JB-toriel/Audio_Amp_BE_Elec/Montage1.asc

C1: cap; 10µ
C2: cap; 10µ
C3: cap; 1µ
C4: cap; 10n
C5: cap; 1n
C6: cap; 10n
C9: cap; 100n
C10: cap; 1n
R1: res; 2.2K
R2: res; 2.2K
R3: res; 100k
R4: res; 100k
R5: res; 1K
R6: res; 3.9k
R7: res; 8.2k
R8: res; 100k
R9: res; 1k
R10: res; 100
R11: res; 100k
R12: res; 47k
R13: res; 8.2k
R14: res; 39k
R15: res; 1k
R16: res; 100
R17: res; 100K
R19: res; 3.9k
R20: res; 39k
R21: res; 100
R22: res; 1k
U1: UniversalOpamp2
U2: UniversalOpamp2
U3: UniversalOpamp2
U4: UniversalOpamp2
U5: UniversalOpamp2
V1: voltage; SINE(1 1 15K)
V2: voltage; SINE(1 1 15K)
V3: voltage; 5
V4: voltage; 2.5; AC 1
V5: voltage; 2.5; AC 1
V6: voltage; 2.5; AC 1
Named nets: 0, VCC, VS1, VD, VG, VCC/2, VSG, VSA, VS, VSM
;tran 0 1ms 0 0.001ms
.ac dec 10 10 30K
