JB-toriel/Audio_Amp_BE_Elec/Circuit1_filtres/Circuit1.kicad_pcb

## KiCad design Circuit1_filtres/Circuit1.kicad_pcb (2020-01-26)

Schematic: Circuit1.sch

Parts:
C1, C2: 10u; C_1206_3216Metric_Pad1.42x1.75mm_HandSolder
C3: 1u; C_1206_3216Metric_Pad1.42x1.75mm_HandSolder
C4, C6: 10n; C_1206_3216Metric_Pad1.42x1.75mm_HandSolder
C5, C8: 1n; C_1206_3216Metric_Pad1.42x1.75mm_HandSolder
C7: 100n; C_1206_3216Metric_Pad1.42x1.75mm_HandSolder
J1: AudioJack3_Ground; Jack_3.5mm_PJ320D_Horizontal
J2: Conn_01x02_Female; PinHeader_1x02_P2.54mm_Vertical
J3: Conn_01x03_Female; PinHeader_1x03_P2.54mm_Vertical
R1, R2: 100k; R_1206_3216Metric_Pad1.42x1.75mm_HandSolder
R3, R6: 1k; R_1206_3216Metric_Pad1.42x1.75mm_HandSolder
R4, R9: 8.2k; R_1206_3216Metric_Pad1.42x1.75mm_HandSolder
R5: 3.9; R_1206_3216Metric_Pad1.42x1.75mm_HandSolder
R8: 3.9k; R_1206_3216Metric_Pad1.42x1.75mm_HandSolder
R10, R11: 39k; R_1206_3216Metric_Pad1.42x1.75mm_HandSolder
R13: 0; R_1206_3216Metric_Pad1.42x1.75mm_HandSolder
RV1, RV2, RV3: 10k; Potentiometer_Vishay_TS53YL_Vertical
Rpont1, Rpont2: 100k; R_1206_3216Metric_Pad1.42x1.75mm_HandSolder
U1: TSV912IDT; SOIC-8_3.9x4.9mm_P1.27mm
Ufiltre1: TSV912IDT; SOIC-8_3.9x4.9mm_P1.27mm
Ufiltrebis1: TSV912IDT; SOIC-8_3.9x4.9mm_P1.27mm

Connections:
GND: J1.S, J2.2, J3.2, Rpont2.1, U1.4 (V-), Ufiltre1.4 (V-), Ufiltrebis1.4 (V-)
unnamed: C1.1, R1.2
unnamed: C1.2, J1.R
unnamed: C2.1, R2.2
unnamed: C2.2, J1.T
unnamed: C3.1, C6.2, R10.2, Ufiltrebis1.2 (-)
unnamed: C3.2, R4.1
unnamed: C4.1, C5.2, R9.2, Ufiltre1.2 (-)
unnamed: C4.2, R5.1
unnamed: C5.1, R9.1, RV1.1, RV1.2, Ufiltre1.1
unnamed: C6.1, R10.1, RV2.2, RV2.3, Ufiltrebis1.1
unnamed: C7.1, C8.2, R11.2, Ufiltre1.6 (-)
unnamed: C7.2, R8.1
unnamed: C8.1, R11.1, RV3.1, RV3.2, Ufiltre1.7
unnamed: J3.1, R6.1, U1.7
unnamed: R1.1, R2.1, R3.2, U1.2 (-)
unnamed: R6.2, RV1.3, RV2.1, RV3.3, U1.6 (-)
unnamed: R4.2, R5.2, R8.2, R13.1
unnamed: R3.1, R13.2, U1.1
VCC: J2.1, J3.3, Rpont1.2, U1.8 (V+), Ufiltre1.8 (V+), Ufiltrebis1.8 (V+)
Vcc:2: Rpont1.1, Rpont2.2, U1.3 (+), U1.5 (+), Ufiltre1.3 (+), Ufiltre1.5 (+), Ufiltrebis1.3 (+)

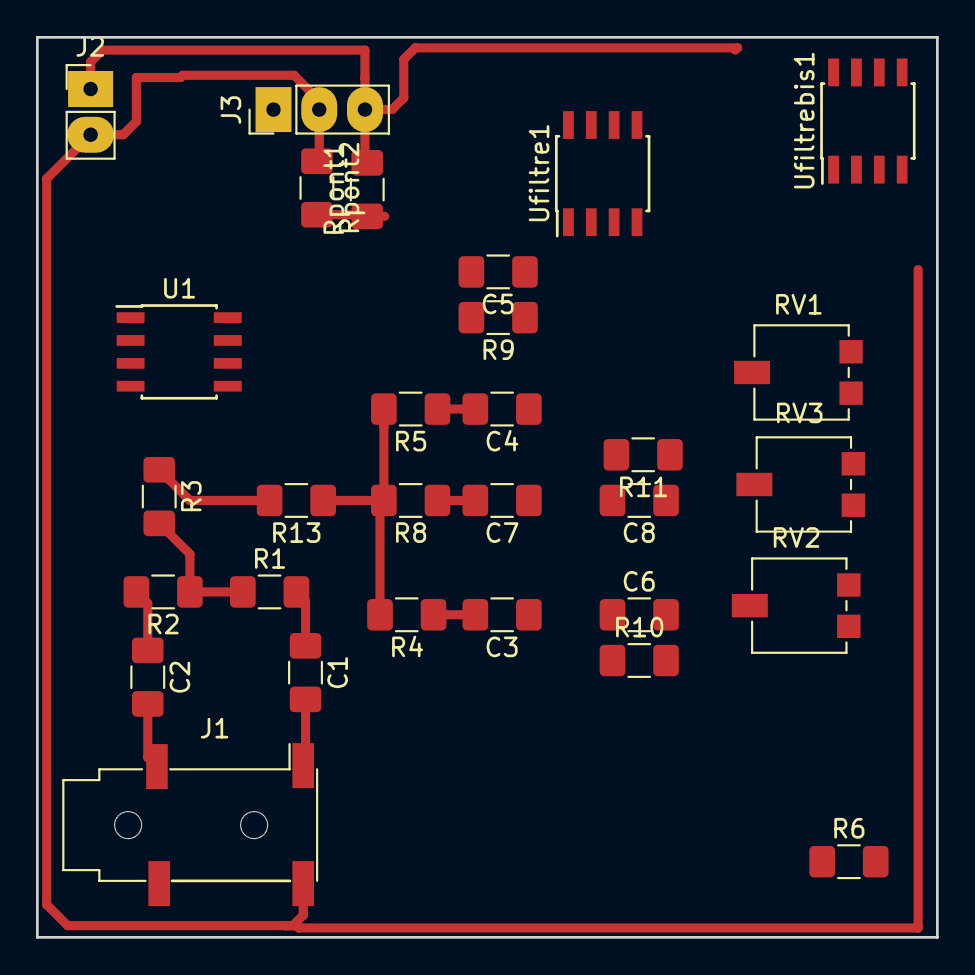
[picture p6: board Circuit1.kicad_pcb from above]

Board: 2 copper layers, 50.0 x 50.0 mm, 30 parts (0 on the bottom side), 21 nets.
